Thundermancers/Elevador-Assembly/Arquitetura/Base_estrutura.pdf

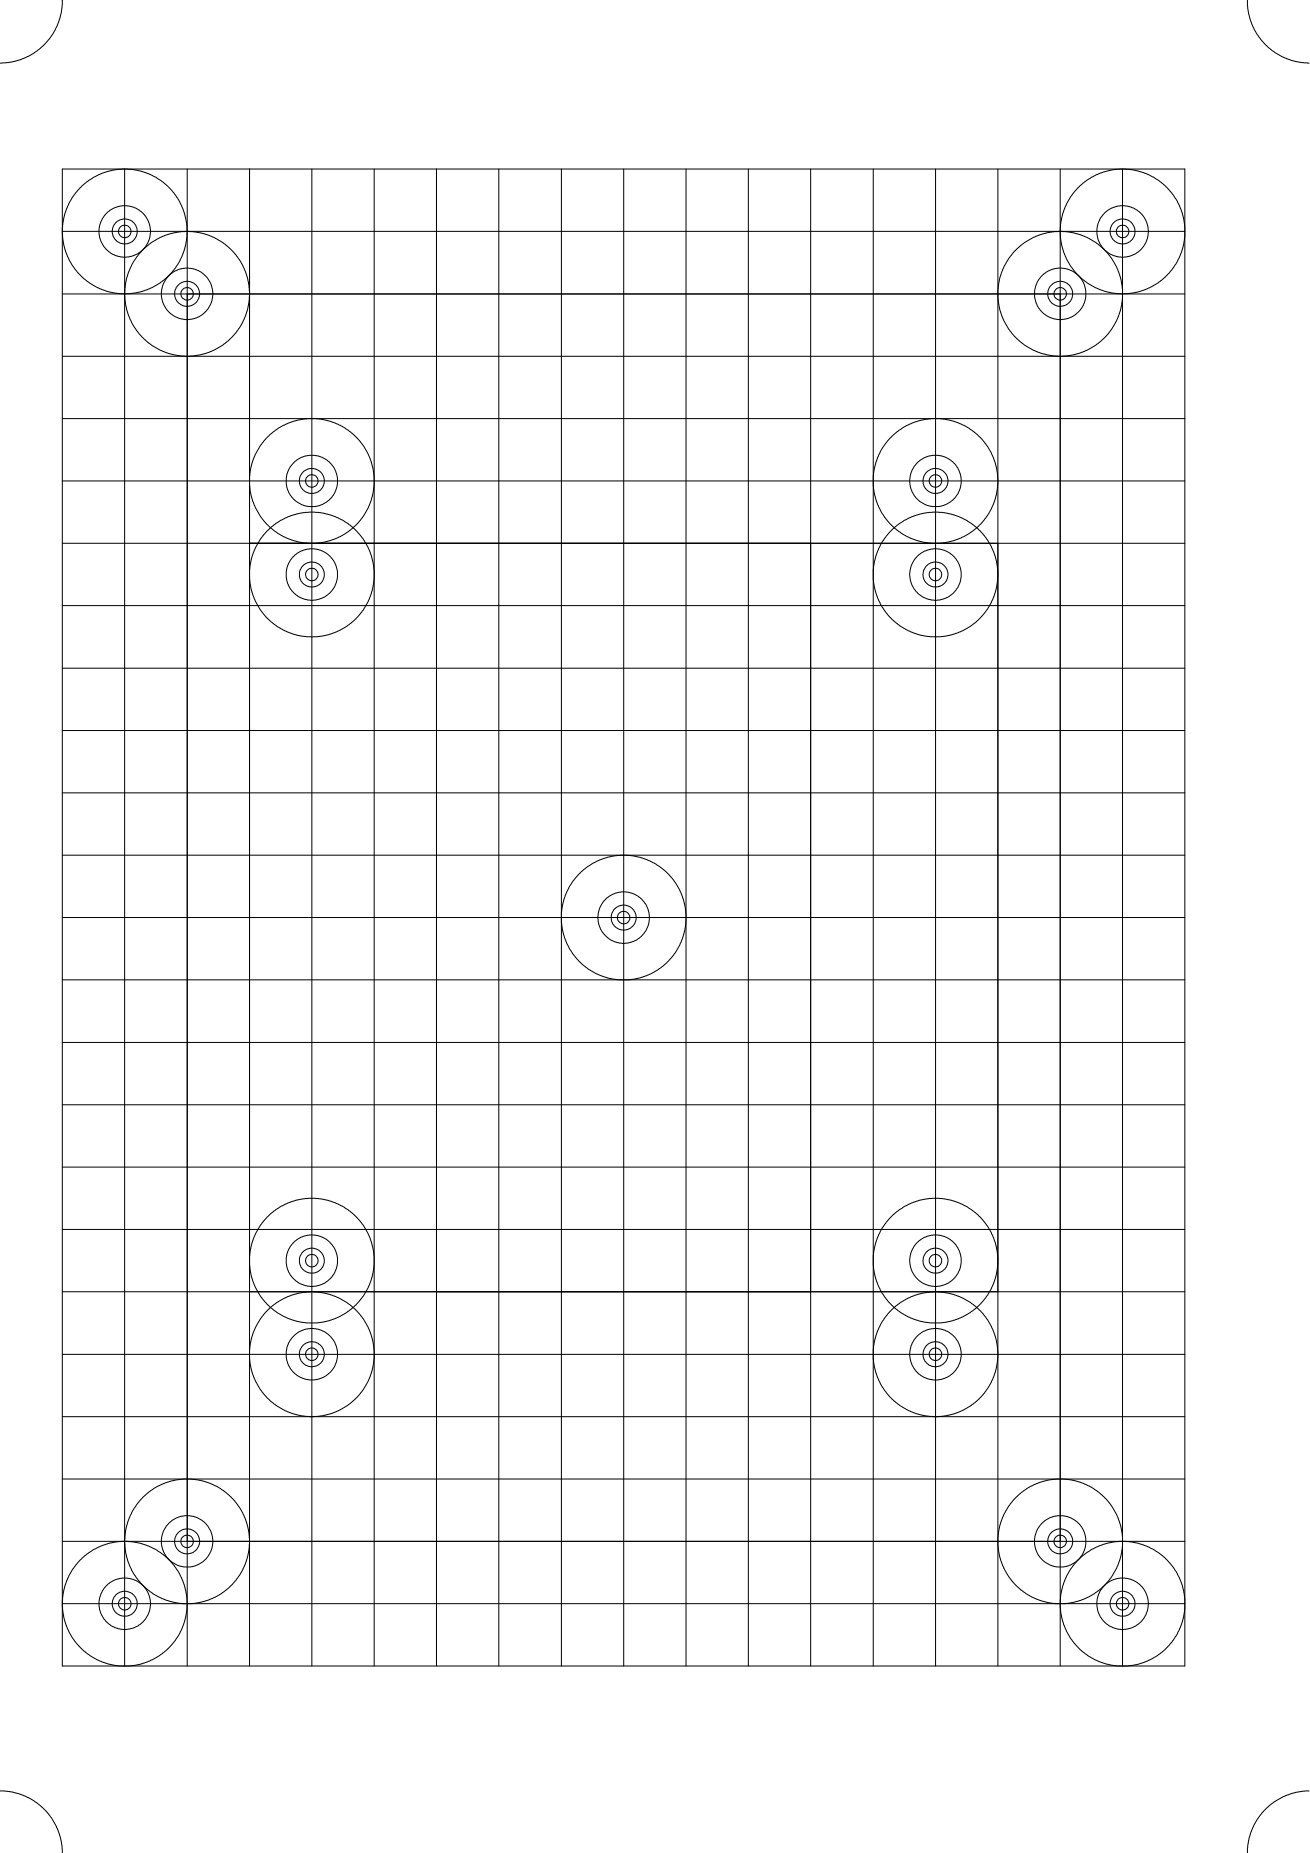
[picture p10: page 1]
