Thundermancers/Elevador-Assembly/(commit log)

2018-09-04 Invertendo ordem do print.
2018-10-02 Corrigindo erros do elevador_ino
    [elevador_ino.ino, manager.cpp, manager.h, outputs.cpp, outputs.h]
2018-10-16 Base para furo dos parafusos de metro
2018-10-17 Corrigindo bugs no merge.
    [manager.cpp, manager.h]
2018-10-17 Reorganizando a árvore de diretórios.
